FiachAntaw/smartknob-s3/electronics/view_base/view_base.kicad_pcb

## KiCad design electronics/view_base/view_base.kicad_pcb (2023-09-06)

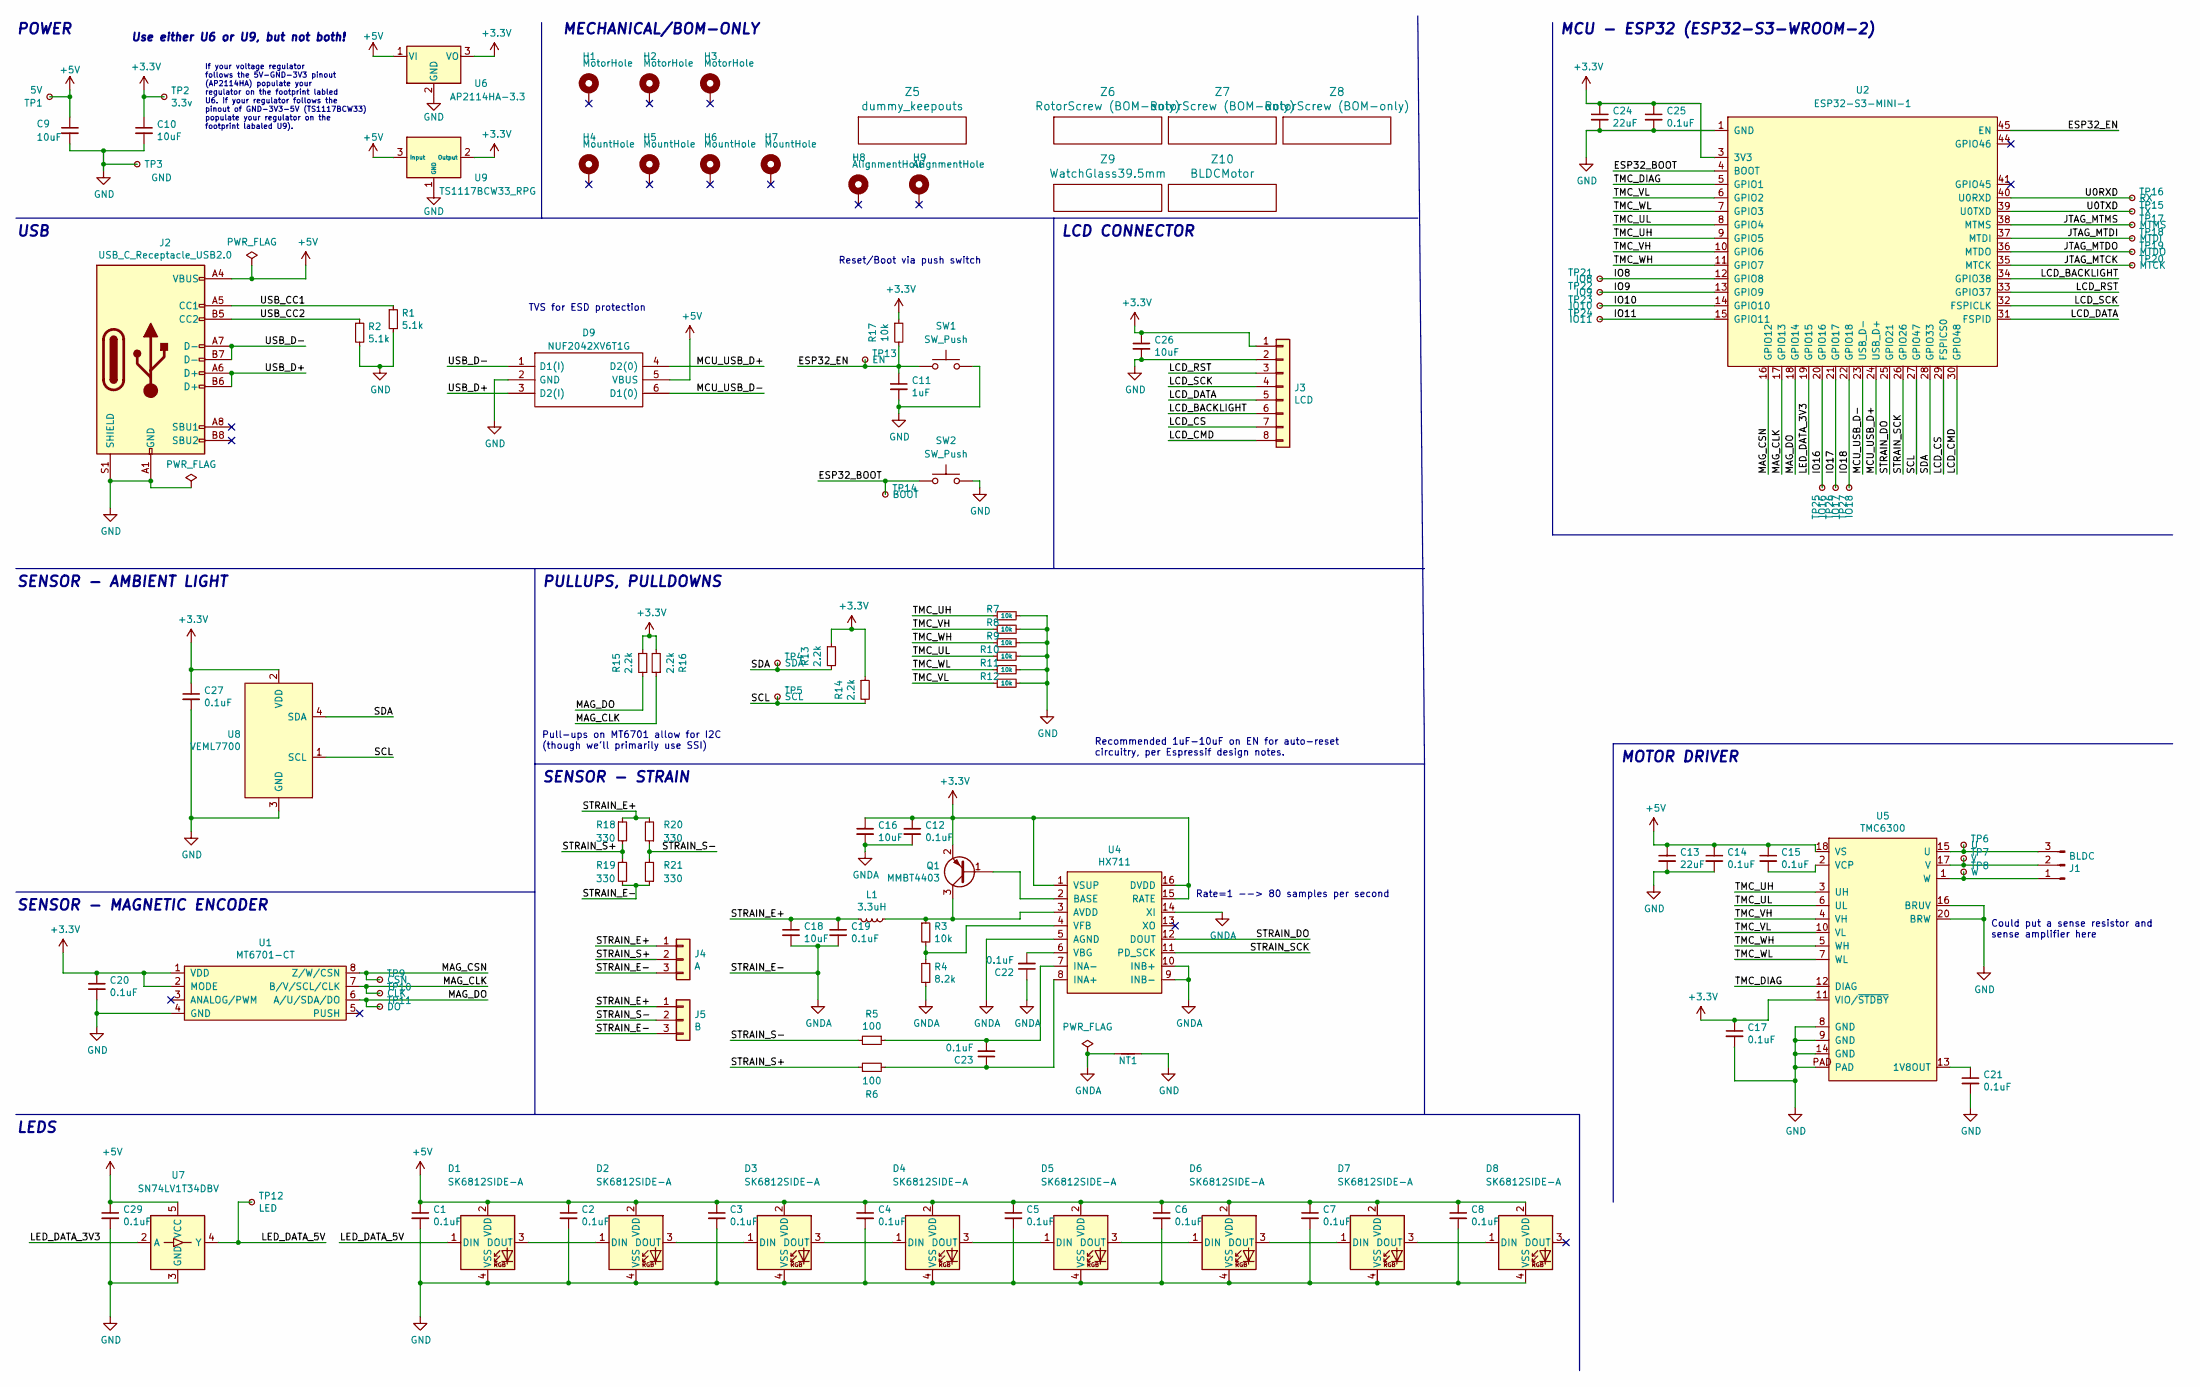
[picture p1: schematic view_base.kicad_sch, SmartKnob View]

Parts:
C1, C2, C3, C4, C5, C6, C7, C8, C12, C14, C15, C17, C19, C20, C21, C22, C23, C25, C27, C29: 0.1uF; C_0603_1608Metric; LCSC C1591
C9, C10, C16, C18, C26: 10uF; C_0805_2012Metric; LCSC C2922480
C11: 1uF; C_0603_1608Metric; Mouser 187-CL10A105KA8NNNC
C13, C24: 22uF; C_0805_2012Metric; LCSC C98190
D1, D2, D3, D4, D5, D6, D7, D8: SK6812SIDE-A; SK6812-SIDE-A; Digikey 1528-4691-ND
D9: NUF2042XV6T1G; SOT-563; Mouser Part Number 863-NUF2042XV6T1G
H1, H2, H3: MotorHole; MountingHole_M1.6; LCSC C2931389
H4, H5, H6, H7: MountHole; MountingHole_2.2mm_M2_ISO7380_Pad_NonVirtual; LCSC C2911210 or C2911532 (screw), C2961595 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
H8, H9: AlignmentHole; MountingHole_2.2mm_M2_ISO7380_Pad_NonVirtual
J1: BLDC; 532610371; LCSC C293630
J2: USB_C_Receptacle_USB2.0; USB4510_NoPaste; LCSC C428463
J3: LCD; SolderPads_2mm_8
J4: A; SolderPads_2mm_3_STRAIN
J5: B; SolderPads_2mm_3_STRAIN
L1: 3.3uH; L_0805_2012Metric; LCSC C307744
NT1: NetTie_2; NetTie-2_SMD_Pad0.5mm
Q1: MMBT4403; SOT-23; LCSC C78864
R1, R2: 5.1k; R_0603_1608Metric; LCSC C105580
R3, R7, R8, R9, R10, R11, R12, R17: 10k; R_0603_1608Metric; LCSC C98220
R4: 8.2k; R_0603_1608Metric; LCSC C114637
R5, R6: 100; R_0603_1608Metric; LCSC C319953
R13, R14, R15, R16: 2.2k; R_0603_1608Metric; LCSC C4190
R18, R19, R20, R21: 330; R_2512_6332Metric; LCSC C19866
SW1, SW2: SW_Push; SW_SPST_B3U-3000P-B
TP1: 5V; TestPoint_Pad_D2.0mm_ValueSilk
TP2: 3.3v; TestPoint_Pad_D2.0mm_ValueSilk
TP3: GND; TestPoint_Pad_D2.0mm_ValueSilk
TP4: SDA; TestPoint_Pad_D2.0mm_ValueSilk
TP5: SCL; TestPoint_Pad_D2.0mm_ValueSilk
TP6: U; TestPoint_Pad_D2.0mm_ValueSilk
TP7: V; TestPoint_Pad_D2.0mm_ValueSilk
TP8: W; TestPoint_Pad_D2.0mm_ValueSilk
TP9: CSN; TestPoint_Pad_D2.0mm_ValueSilk
TP10: CLK; TestPoint_Pad_D2.0mm_ValueSilk
TP11: DO; TestPoint_Pad_D2.0mm_ValueSilk
TP12: LED; TestPoint_Pad_D2.0mm_ValueSilk
TP13: EN; TestPoint_Pad_D2.0mm_ValueSilk
TP14: BOOT; TestPoint_Pad_D2.0mm_ValueSilk
TP15: TX; TestPoint_Pad_D2.0mm_ValueSilk
TP16: RX; TestPoint_Pad_D2.0mm_ValueSilk
TP17: MTMS; TestPoint_Pad_D2.0mm_ValueSilk
TP18: MTDI; TestPoint_Pad_D2.0mm_ValueSilk
TP19: MTDO; TestPoint_Pad_D2.0mm_ValueSilk
TP20: MTCK; TestPoint_Pad_D2.0mm_ValueSilk
TP21: IO8; TestPoint_Pad_D2.0mm_ValueSilk
TP22: IO9; TestPoint_Pad_D2.0mm_ValueSilk
TP23: IO10; TestPoint_Pad_D2.0mm_ValueSilk
TP24: IO11; TestPoint_Pad_D2.0mm_ValueSilk
TP25: IO16; TestPoint_Pad_D2.0mm_ValueSilk
TP26: IO17; TestPoint_Pad_D2.0mm_ValueSilk
TP27: IO18; TestPoint_Pad_D2.0mm_ValueSilk
U1: MT6701-CT; SOIC-8_3.9x4.9mm_P1.27mm; LCSC C2856764, or C3003196
U2: ESP32-S3-MINI-1
U4: HX711; SOIC-16_3.9x9.9mm_P1.27mm; LCSC C43656
U5: TMC6300; QFN-20-1EP_3x3mm_P0.4mm_EP1.65x1.65mm_ThermalVias_LargerVia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; Digikey TMC6300-LA-T
U6: AP2114HA-3.3; SOT-223-3_TabPin2_InGndOut; LCSC C460314
U7: SN74LV1T34DBV; SOT-23-5; LCSC C100024
U8: VEML7700; VEML7700-TOP; Digikey VEML7700-TT
U9: TS1117BCW33_RPG; SOT-223-3_TabPin2_GndOutIn; LCSC C6186, C35879, or others
Z5: dummy_keepouts; ViewKeepouts3d
Z6, Z7, Z8: RotorScrew (BOM-only); bom_only_no_pin
Z9: WatchGlass39.5mm; bom_only_no_pin
Z10: BLDCMotor; bom_only_no_pin

Connections:
+3V3: C10.1, C12.1, C16.1, C17.1, C20.1, C24.1, C25.1, C26.1, C27.1, J3.1, Q1.2 (E), R13.1, R14.1, R15.1, R16.2, R17.1, TP2.1, U1.1 (VDD), U1.2 (MODE), U2.3 (3V3), U4.1 (VSUP), U4.15 (RATE), U4.16 (DVDD), U5.11 (VIO/~STDBY), U6.3 (VO), U8.2 (VDD), U9.2 (Output)
+5V: C1.1, C2.1, C3.1, C4.1, C5.1, C6.1, C7.1, C8.1, C9.1, C13.1, C14.1, C15.1, C29.1, D1.2 (VDD), D2.2 (VDD), D3.2 (VDD), D4.2 (VDD), D5.2 (VDD), D6.2 (VDD), D7.2 (VDD), D8.2 (VDD), D9.5 (VBUS), J2.A4 (VBUS), J2.A9 (VBUS), J2.B4 (VBUS), J2.B9 (VBUS), TP1.1, U5.18 (VS), U6.1 (VI), U7.5 (VCC), U9.3 (Input)
/ESP32_BOOT: SW2.1, TP14.1, U2.4 (BOOT)
/ESP32_EN: C11.1, R17.2, SW1.1, TP13.1, U2.45 (EN)
/IO8: TP21.1, U2.12 (GPIO8)
/IO9: TP22.1, U2.13 (GPIO9)
/IO10: TP23.1, U2.14 (GPIO10)
/IO11: TP24.1, U2.15 (GPIO11)
/IO16: TP25.1, U2.20 (GPIO16)
/IO17: TP26.1, U2.21 (GPIO17)
/IO18: TP27.1, U2.22 (GPIO18)
/JTAG_MTCK: TP20.1, U2.35 (MTCK)
/JTAG_MTDI: TP18.1, U2.37 (MTDI)
/JTAG_MTDO: TP19.1, U2.36 (MTDO)
/JTAG_MTMS: TP17.1, U2.38 (MTMS)
/LCD_BACKLIGHT: J3.6, U2.34 (GPIO38)
/LCD_CMD: J3.8, U2.30 (GPIO48)
/LCD_CS: J3.7, U2.29 (FSPICS0)
/LCD_DATA: J3.5, U2.31 (FSPID)
/LCD_RST: J3.3, U2.33 (GPIO37)
/LCD_SCK: J3.4, U2.32 (FSPICLK)
/LED_DATA_3V3: U2.19 (GPIO15), U7.2 (A)
/LED_DATA_5V: D1.1 (DIN), TP12.1, U7.4 (Y)
/MAG_CLK: R16.1, TP10.1, U1.7 (B/V/SCL/CLK), U2.17 (GPIO13)
/MAG_CSN: TP9.1, U1.8 (Z/W/CSN), U2.16 (GPIO12)
/MAG_DO: R15.2, TP11.1, U1.6 (A/U/SDA/DO), U2.18 (GPIO14)
/MCU_USB_D+: D9.4 (D2(0)), U2.24 (USB_D+)
/MCU_USB_D-: D9.6 (D1(0)), U2.23 (USB_D-)
/SCL: R14.2, TP5.1, U2.27 (GPIO47), U8.1 (SCL)
/SDA: R13.2, TP4.1, U2.28 (GPIO33), U8.4 (SDA)
/STRAIN_DO: U2.25 (GPIO21), U4.12 (DOUT)
/STRAIN_E+: C18.1, C19.1, J4.1, J5.1, L1.2, R18.1, R20.2
/STRAIN_S+: J4.2, R6.1, R18.2, R19.1
/STRAIN_S-: J5.2, R5.2, R20.1, R21.2
/STRAIN_SCK: U2.26 (GPIO26), U4.11 (PD_SCK)
/TMC_DIAG: U2.5 (GPIO1), U5.12 (DIAG)
/TMC_UH: R7.1, U2.9 (GPIO5), U5.3 (UH)
/TMC_UL: R10.1, U2.8 (GPIO4), U5.6 (UL)
/TMC_VH: R8.1, U2.10 (GPIO6), U5.4 (VH)
/TMC_VL: R12.1, U2.6 (GPIO2), U5.10 (VL)
/TMC_WH: R9.1, U2.11 (GPIO7), U5.5 (WH)
/TMC_WL: R11.1, U2.7 (GPIO3), U5.7 (WL)
/U0RXD: TP16.1, U2.40 (U0RXD)
/U0TXD: TP15.1, U2.39 (U0TXD)
/USB_CC1: J2.A5 (CC1), R1.1
/USB_CC2: J2.B5 (CC2), R2.1
/USB_D+: D9.3 (D2(I)), J2.A6 (D+), J2.B6 (D+)
/USB_D-: D9.1 (D1(I)), J2.A7 (D-), J2.B7 (D-)
GND: C1.2, C2.2, C3.2, C4.2, C5.2, C6.2, C7.2, C8.2, C9.2, C10.2, C11.2, C13.2, C14.2, C17.2, C20.2, C21.2, C24.2, C25.2, C26.2, C27.2, C29.2, D1.4 (VSS), D2.4 (VSS), D3.4 (VSS), D4.4 (VSS), D5.4 (VSS), D6.4 (VSS), D7.4 (VSS), D8.4 (VSS), D9.2 (GND), J2.A1 (GND), J2.A12 (GND), J2.B1 (GND), J2.B12 (GND), J2.S1 (SHIELD), J3.2, NT1.2, R1.2, R2.2, R7.2, R8.2, R9.2, R10.2, R11.2, R12.2, SW1.2, SW2.2, TP3.1, U1.4 (GND), U2.1 (GND), U2.2 (GND), U2.42 (GND), U2.43 (GND), U2.46 (GND), U2.47 (GND), U2.48 (GND), U2.49 (GND), U2.50 (GND), U2.51 (GND), U2.52 (GND), U2.53 (GND), U2.54 (GND), U2.55 (GND), U2.56 (GND), U2.57 (GND), U2.58 (GND), U2.59 (GND), U2.60 (GND), U2.61 (GND), U2.62 (GND), U2.63 (GND), U2.64 (GND), U2.65 (GND), U5.8 (GND), U5.9 (GND), U5.14 (GND), U5.16 (BRUV), U5.20 (BRW), U5.PAD, U6.2 (GND), U7.3 (GND), U8.3 (GND), U9.1 (GND)
GNDA: C12.2, C16.2, C18.2, C19.2, C22.1, J4.3, J5.3, NT1.1, R4.2, R19.2, R21.1, U4.5 (AGND), U4.9 (INB-), U4.10 (INB+), U4.14 (XI)
unnamed: D1.3 (DOUT), D2.1 (DIN)
unnamed: D2.3 (DOUT), D3.1 (DIN)
unnamed: D3.3 (DOUT), D4.1 (DIN)
unnamed: D4.3 (DOUT), D5.1 (DIN)
unnamed: D5.3 (DOUT), D6.1 (DIN)
unnamed: D6.3 (DOUT), D7.1 (DIN)
unnamed: D7.3 (DOUT), D8.1 (DIN)
unnamed: J1.1, TP8.1, U5.1 (W)
unnamed: J1.2, TP7.1, U5.17 (V)
unnamed: J1.3, TP6.1, U5.15 (U)
unnamed: Q1.1 (B), U4.2 (BASE)
unnamed: L1.1, Q1.3 (C), R3.1, U4.3 (AVDD)
unnamed: C23.1, R6.2, U4.8 (INA+)
unnamed: C23.2, R5.1, U4.7 (INA-)
unnamed: C22.2, U4.6 (VBG)
unnamed: R3.2, R4.1, U4.4 (VFB)
unnamed: C21.1, U5.13 (1V8OUT)
unnamed: C15.2, U5.2 (VCP)

Notes on the sheet:
TVS for ESD protection
POWER
Could put a sense resistor and sense amplifier here
MCU - ESP32 (ESP32-S3-WROOM-2)
If your voltage regulator follows the 5V-GND-3V3 pinout (AP2114HA) populate your regulator on the footprint labled U6. If your regulator follows the pinout of GND-3V3-5V (TS1117BCW33) populate your regulator on the footprint labaled U9).
SENSOR - MAGNETIC ENCODER
MOTOR DRIVER
MECHANICAL/BOM-ONLY
Pull-ups on MT6701 allow for I2C (though we'll primarily use SSI)
Use either U6 or U9, but not both!
Rate=1 --> 80 samples per second
SENSOR - AMBIENT LIGHT
Recommended 1uF-10uF on EN for auto-reset circuitry, per Espressif design notes.
USB
SENSOR - STRAIN
LEDS
PULLUPS, PULLDOWNS
LCD CONNECTOR
Reset/Boot via push switch

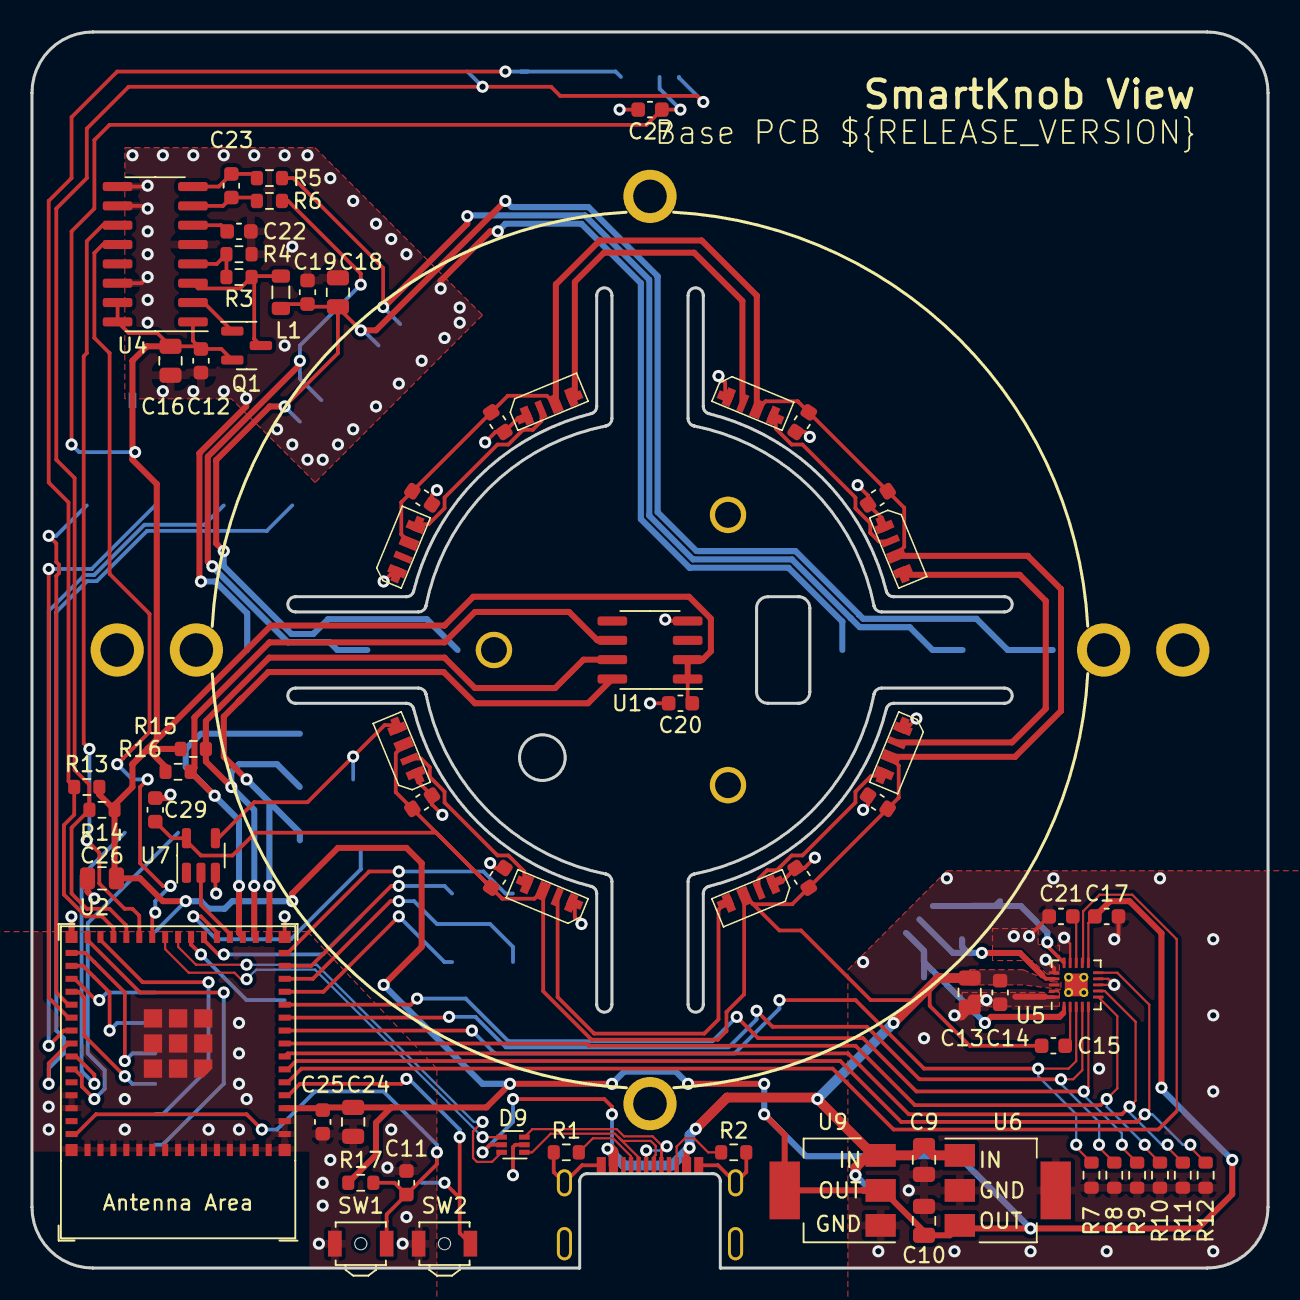
[picture p2: board view_base.kicad_pcb from above]

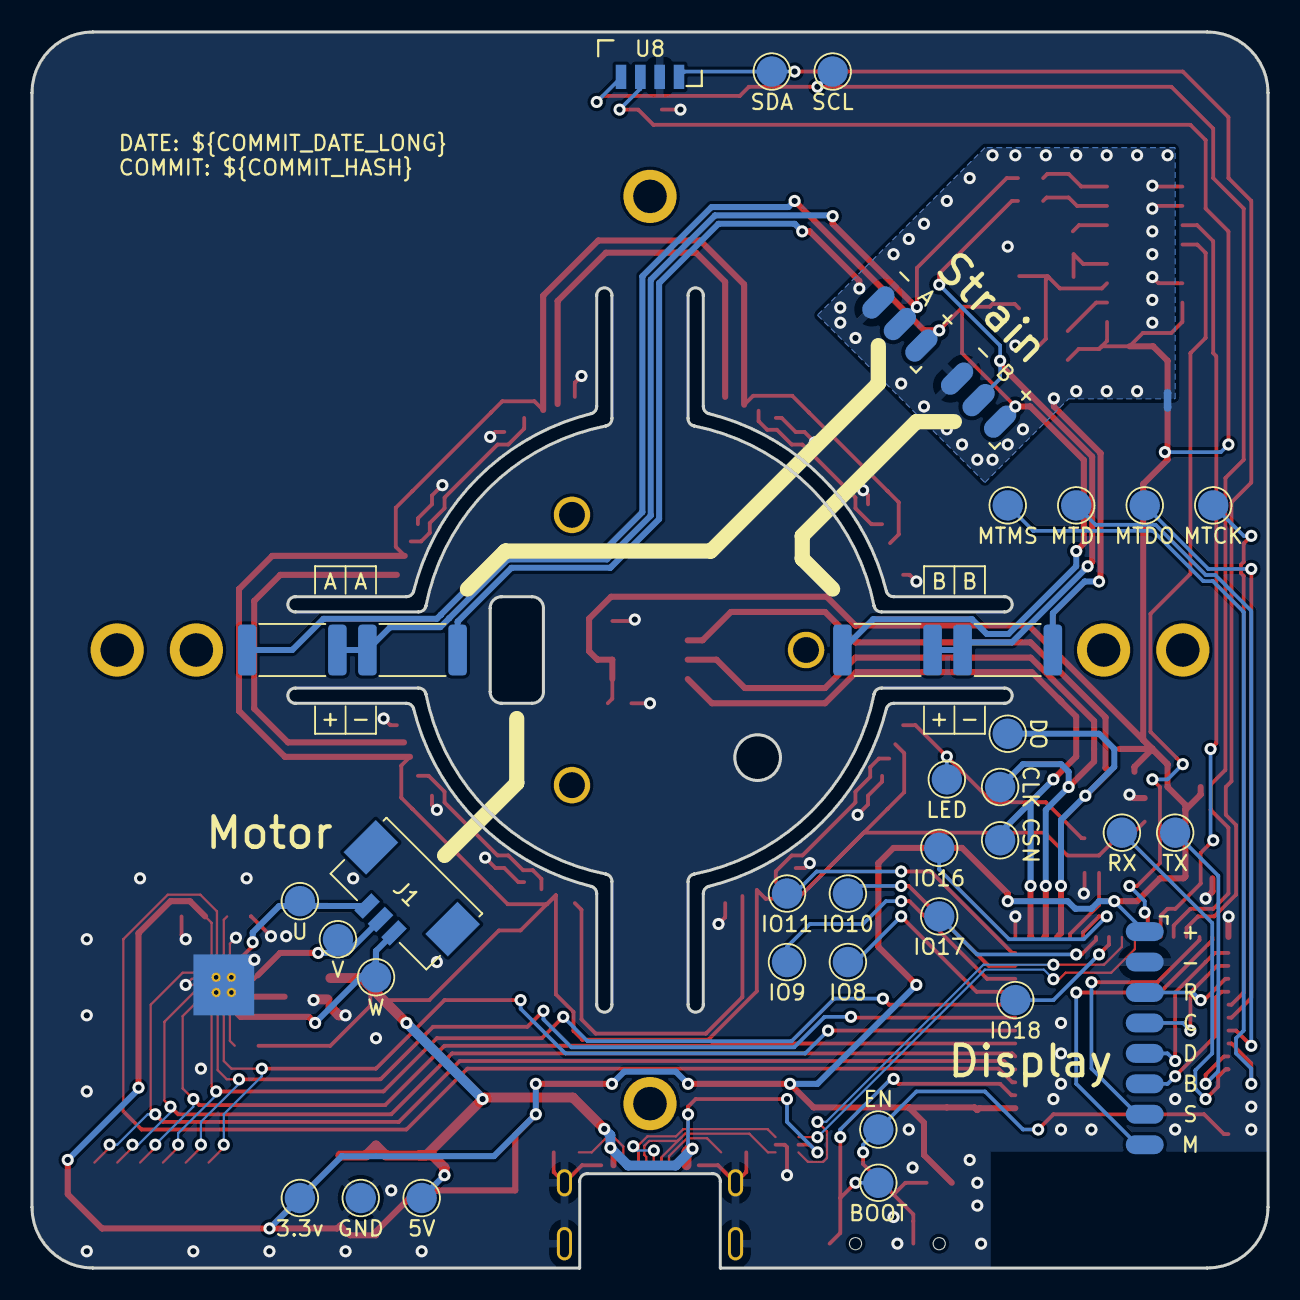
[picture p3: board view_base.kicad_pcb from below]

Board: 2 copper layers, 81.2 x 81.2 mm, 118 parts (37 on the bottom side), 68 nets.
