FiachAntaw/smartknob-s3/(commit log)

2023-09-06 Use ESP32-S3-MINI-1 in place of TMicro32 Plus
    [view_base.kicad_pcb, view_base.kicad_sch, view_screen.kicad_pcb]
2023-09-06 Lower LEDC backlight resolution/frequency for S3
2023-09-06 Change MT6701 SPI channel for S3
